YOOBIN-AN/gaze-page-turner/page-actuator/models/camera_case.stl

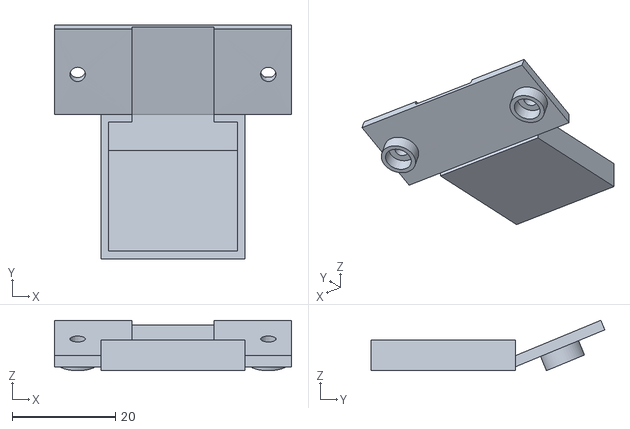
[picture p33: CAD file, 2026-11-06]
page-actuator/models/camera_case.stl
46.0 x 45.3 x 9.79
