YOOBIN-AN/gaze-page-turner/page-actuator/models/servo_case_right.stl

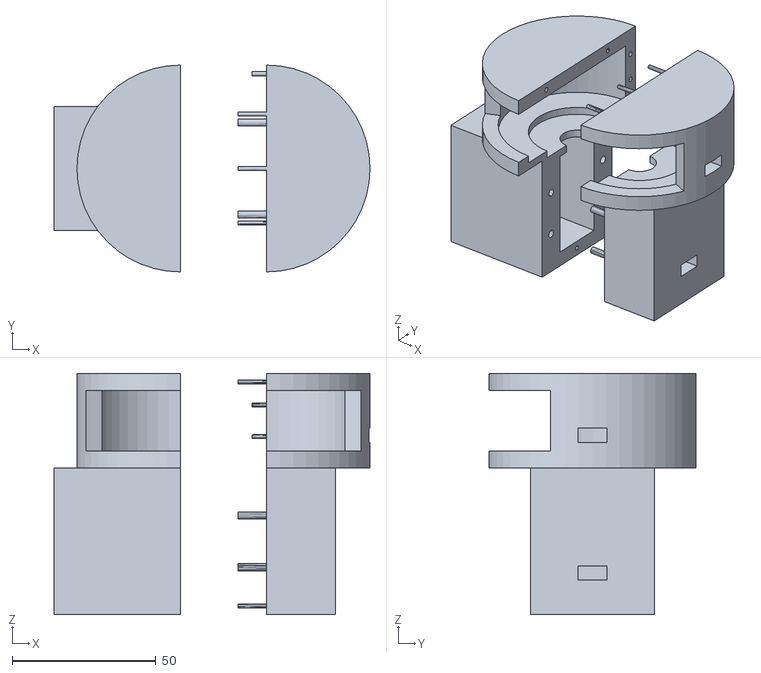
[picture p34: CAD file, 2026-11-06]
page-actuator/models/servo_case_right.stl
110.0 x 72.0 x 84.0
