YOOBIN-AN/gaze-page-turner/page-actuator/models/servo_case_pair.stl

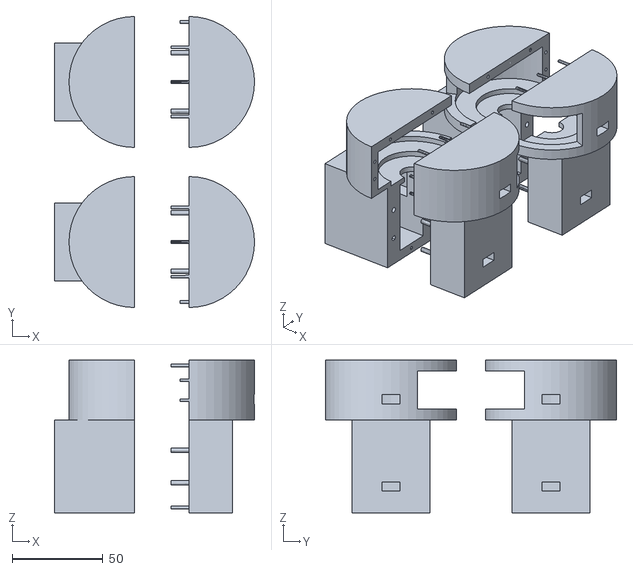
[picture p35: CAD file, 2026-11-06]
page-actuator/models/servo_case_pair.stl
110.0 x 160.0 x 84.0
