YOOBIN-AN/gaze-page-turner/page-actuator/archive/models/servo_case_pair_v1.stl

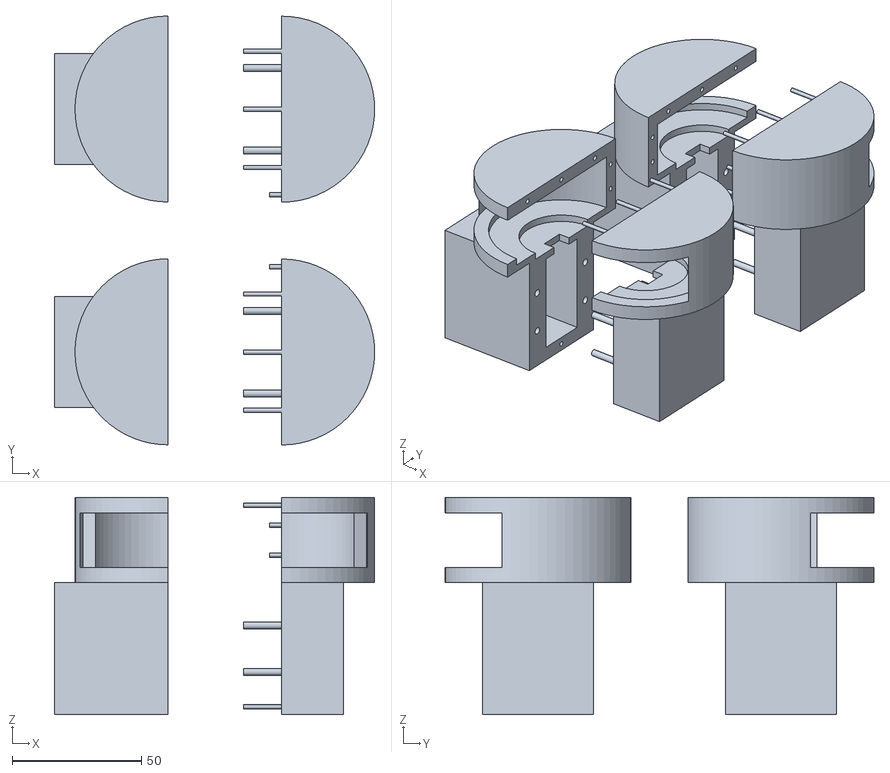
[picture p36: CAD file, 2026-11-06, an earlier design]
page-actuator/archive/models/servo_case_pair_v1.stl
124.0 x 166.1 x 84.0
