YOOBIN-AN/gaze-page-turner/(list of files, cad)

Other CAD files:
page-actuator/models/servo_case_left.stl
