YOOBIN-AN/gaze-page-turner/(commit log)

2026-11-06 Restructure README to match driving-analysis format
    - Rename page-turning-device to page-actuator (② 책장 구동부)
    - Add demo sections, numbered sections and one-line TOC
    - Replace low-res report crops with video frames and STL renders
    - Add servo case STL models, remove empty firmware folder
    [servo_case_left.stl, servo_case_pair.stl, servo_case_right.stl]
2026-11-06 Add ESP32 firmware, camera case model and development archive
    - Add final firmware servo_final.ino with Wi-Fi credentials removed
    - Add run instructions, command and pin tables, correction formulas
    - Add thickness correction demo section and camera case STL
    - Archive test firmware, previous servo case model and early gaze experiments
    [camera_case.stl, servo_case_pair_v1.stl]
2026-11-06 Remove duplicate demo video at top of page-actuator README
2026-11-06 Tighten middle-dot spacing for readability
2026-11-06 Align README details with driving-analysis
    - Restore spaced middle dots, keeping only manually tightened ones
    - Match archive READMEs to driving-analysis archive format
    - Move design notes to the top of the mechanical design section
    - Link archive from troubleshooting details
2026-11-06 Shorten process flow diagram with single-line nodes
2026-11-06 Equalize process flow box widths
2026-11-06 Fix process flow box width with CSS instead of padding
2026-11-09 Unify middle-dot spacing, tighten only role notation
